HuYingTran/Robot_TRRR/digital_twin/meshes/Body018.stl

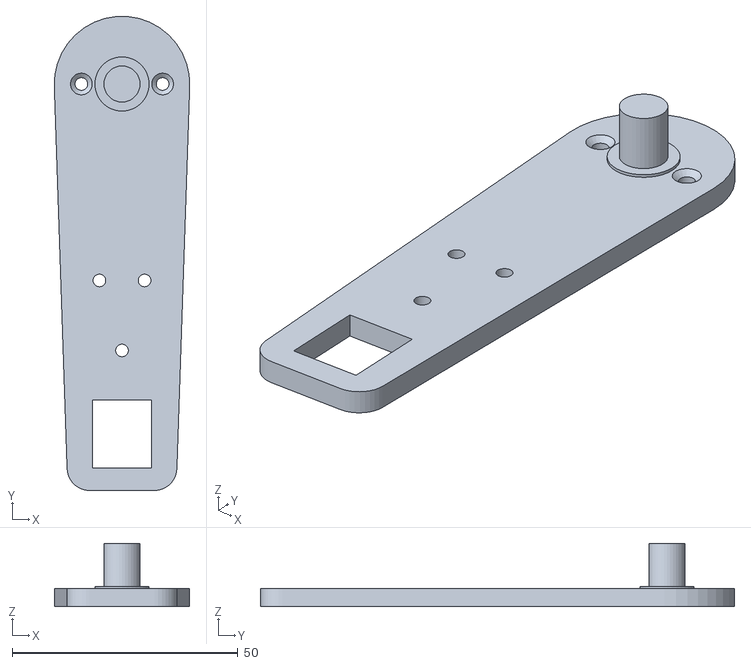
[picture p6: CAD file, 2026-10-16]
digital_twin/meshes/Body018.stl
30.0 x 104.9 x 14.0
