HuYingTran/Robot_TRRR/digital_twin/meshes/SoftGripper__Spool.stl

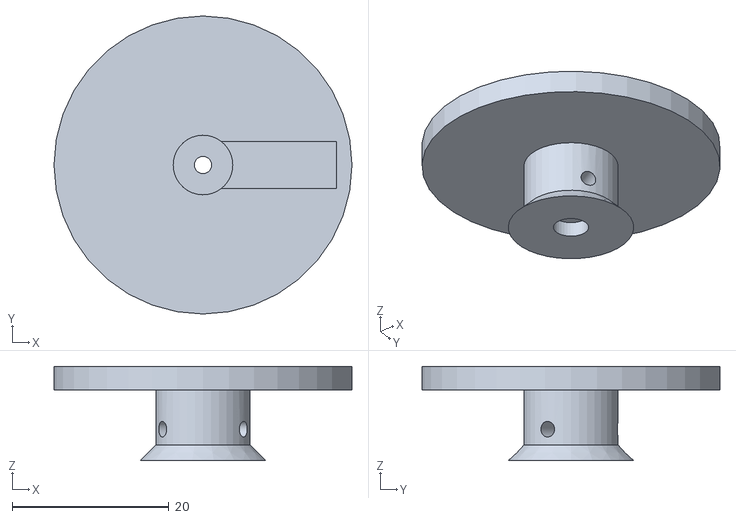
[picture p7: CAD file, 2026-10-16]
digital_twin/meshes/SoftGripper__Spool.stl
38.0 x 38.0 x 12.0
