HuYingTran/Robot_TRRR/digital_twin/meshes/SoftGripper__Palm.stl

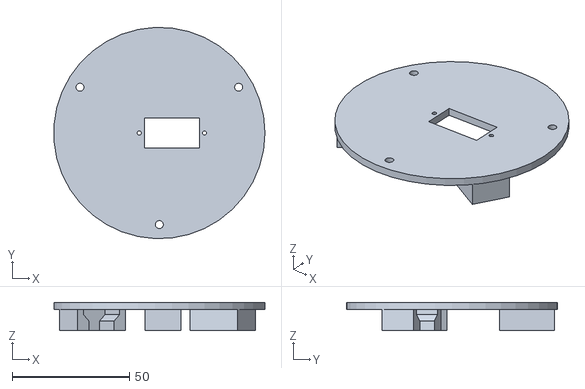
[picture p8: CAD file, 2026-10-16]
digital_twin/meshes/SoftGripper__Palm.stl
89.9 x 89.9 x 12.0
