HuYingTran/Robot_TRRR/digital_twin/meshes/Body016.stl

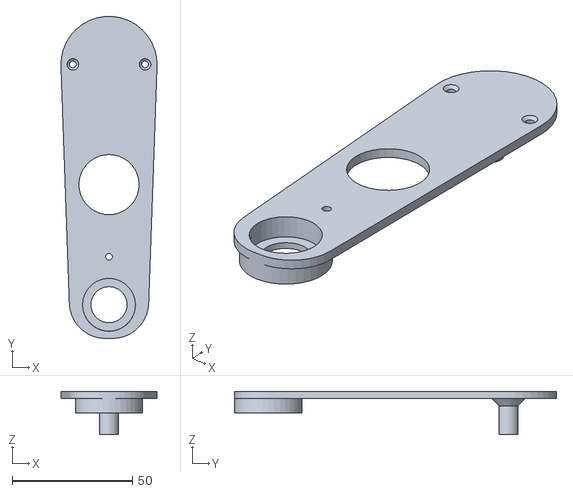
[picture p9: CAD file, 2026-10-16]
digital_twin/meshes/Body016.stl
40.0 x 133.9 x 18.0
