HuYingTran/Robot_TRRR/digital_twin/meshes/SoftGripper__SG90_ref.stl

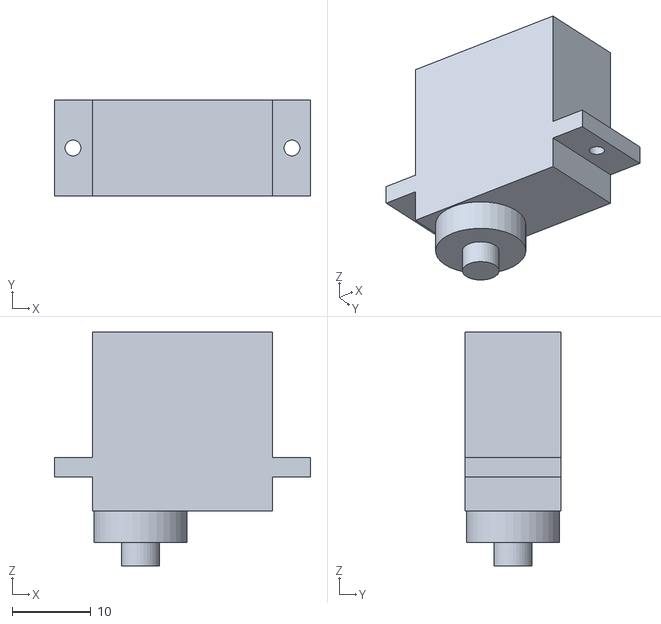
[picture p10: CAD file, 2026-10-16]
digital_twin/meshes/SoftGripper__SG90_ref.stl
32.5 x 12.2 x 29.7
