HuYingTran/Robot_TRRR/digital_twin/meshes/SoftGripper__Horn25_MG995_ref.stl

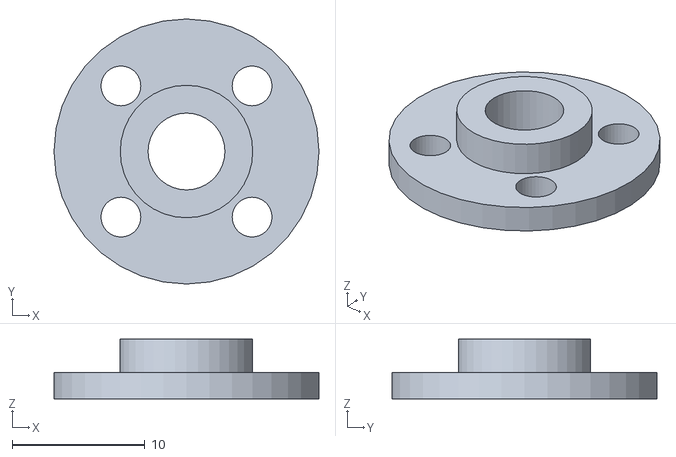
[picture p11: CAD file, 2026-10-16]
digital_twin/meshes/SoftGripper__Horn25_MG995_ref.stl
20.0 x 20.0 x 4.50
