HuYingTran/Robot_TRRR/digital_twin/meshes/Body010.stl

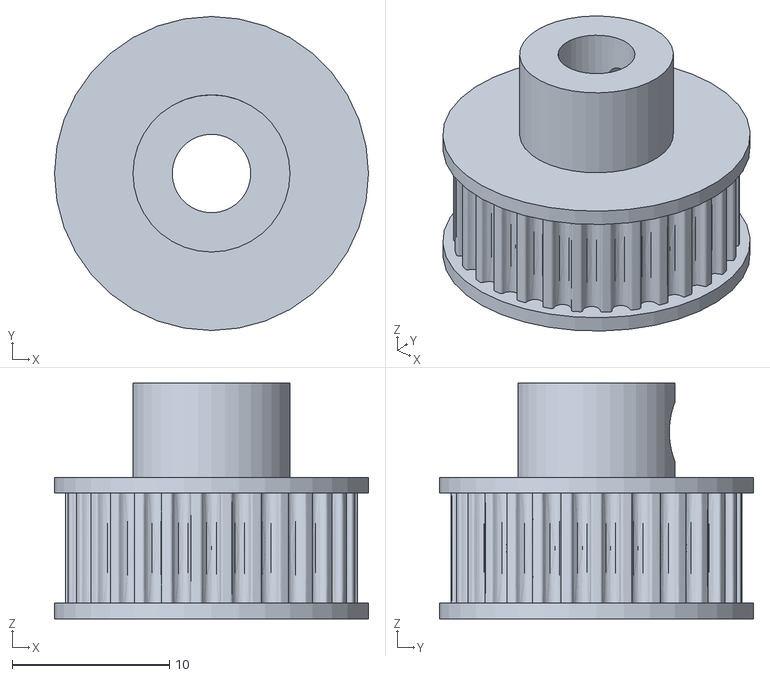
[picture p12: CAD file, 2026-10-16]
digital_twin/meshes/Body010.stl
20.0 x 20.0 x 15.0
