HuYingTran/Robot_TRRR/digital_twin/meshes/Body012.stl

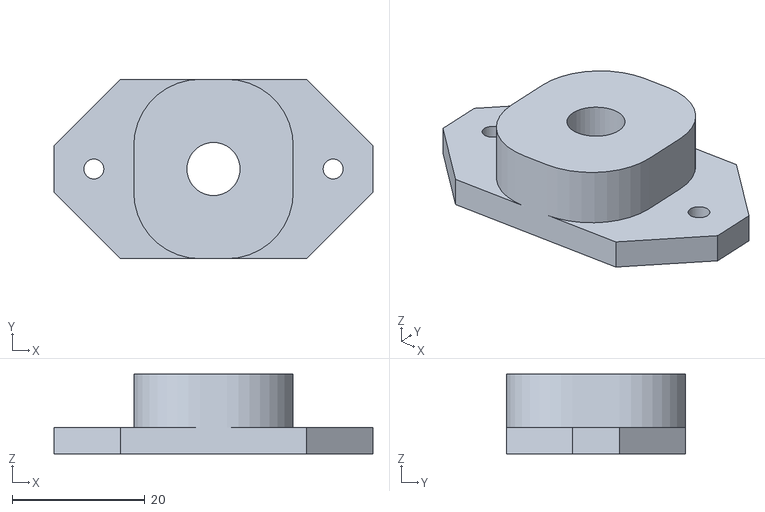
[picture p13: CAD file, 2026-10-16]
digital_twin/meshes/Body012.stl
48.0 x 27.0 x 12.0
