HuYingTran/Robot_TRRR/digital_twin/meshes/SoftGripper__Spacer.stl

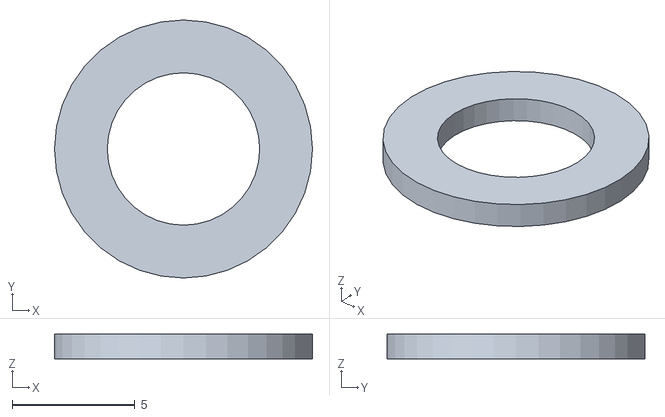
[picture p14: CAD file, 2026-10-16]
digital_twin/meshes/SoftGripper__Spacer.stl
10.5 x 10.5 x 1.00
