HuYingTran/Robot_TRRR/digital_twin/meshes/SoftGripper__Finger_2.stl

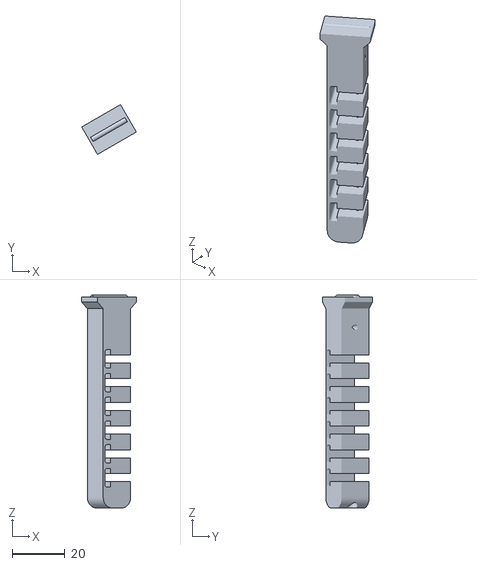
[picture p15: CAD file, 2026-10-16]
digital_twin/meshes/SoftGripper__Finger_2.stl
20.7 x 18.9 x 80.7
