HuYingTran/Robot_TRRR/digital_twin/meshes/Body.stl

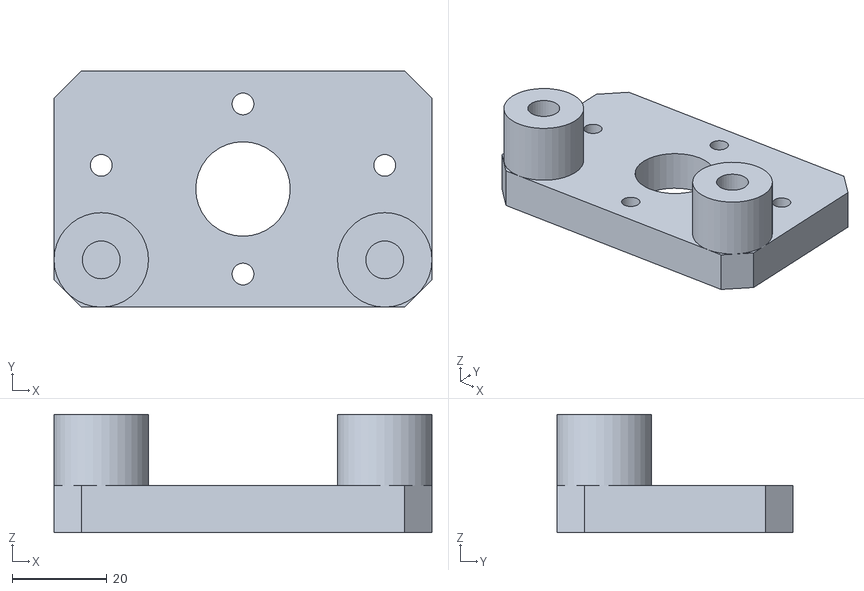
[picture p16: CAD file, 2026-10-16]
digital_twin/meshes/Body.stl
80.0 x 50.0 x 25.0
