HuYingTran/Robot_TRRR/digital_twin/meshes/Body004.stl

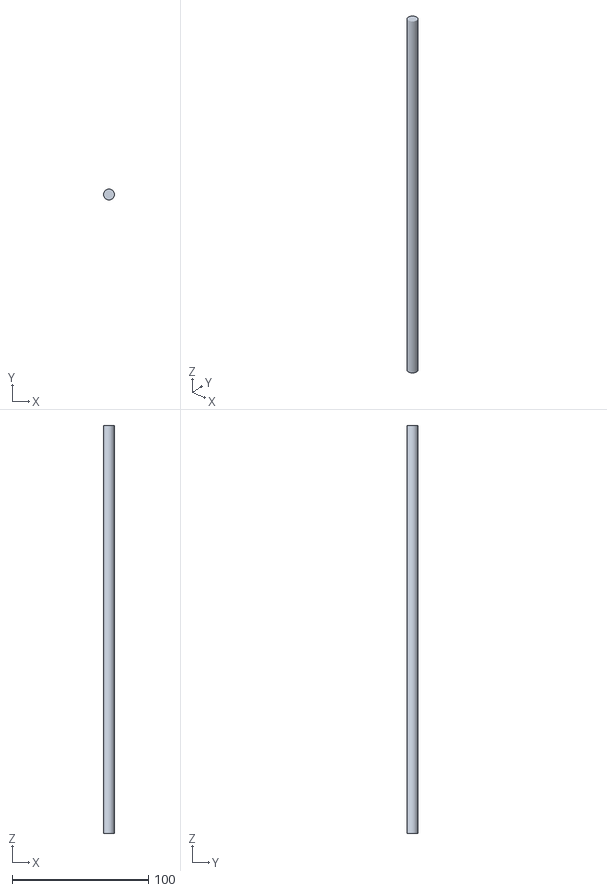
[picture p17: CAD file, 2026-10-16]
digital_twin/meshes/Body004.stl
8.00 x 8.00 x 300.0
