HuYingTran/Robot_TRRR/digital_twin/meshes/Body001.stl

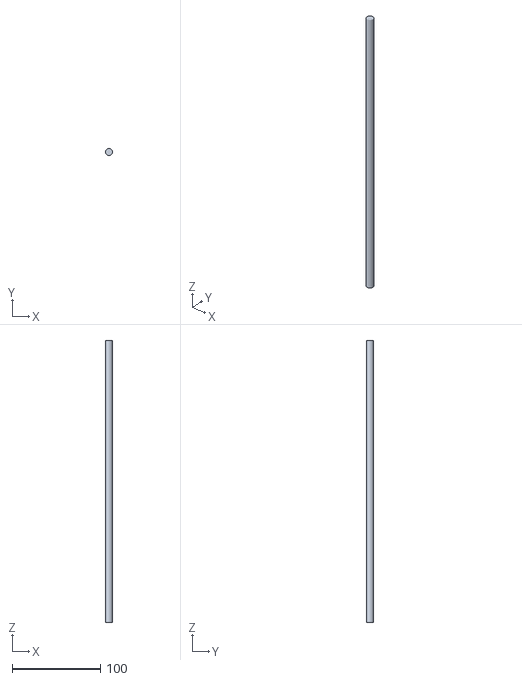
[picture p18: CAD file, 2026-10-16]
digital_twin/meshes/Body001.stl
8.00 x 8.00 x 320.0
