HuYingTran/Robot_TRRR/digital_twin/meshes/Body017.stl

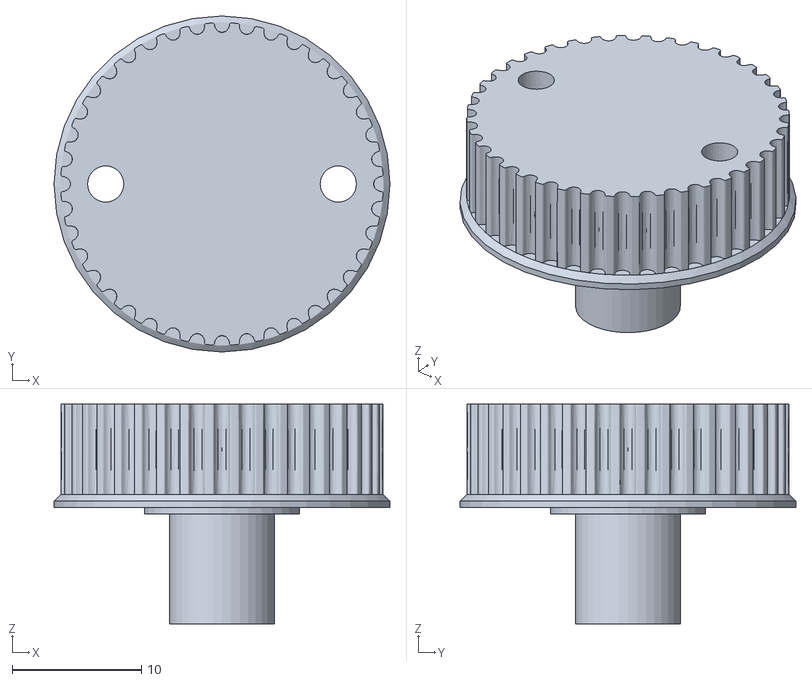
[picture p19: CAD file, 2026-10-16]
digital_twin/meshes/Body017.stl
26.0 x 26.0 x 17.0
