HuYingTran/Robot_TRRR/digital_twin/meshes/Body007.stl

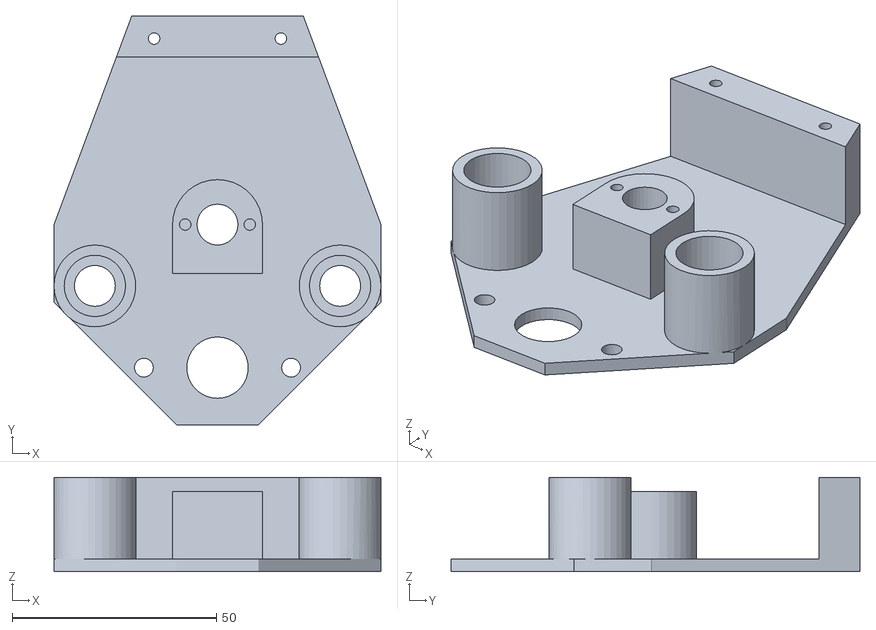
[picture p20: CAD file, 2026-10-16]
digital_twin/meshes/Body007.stl
80.0 x 100.0 x 23.0
