HuYingTran/Robot_TRRR/digital_twin/meshes/Body005.stl

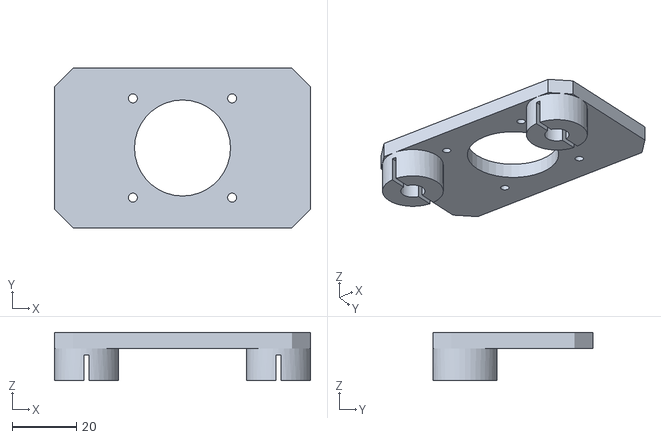
[picture p21: CAD file, 2026-10-16]
digital_twin/meshes/Body005.stl
80.0 x 50.0 x 15.0
