HuYingTran/Robot_TRRR/digital_twin/meshes/Body011.stl

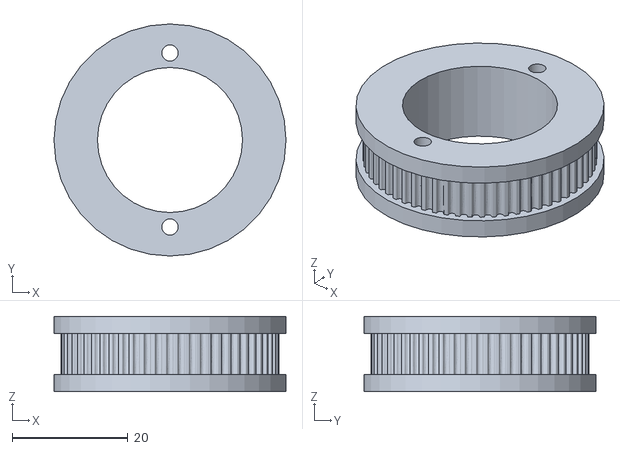
[picture p22: CAD file, 2026-10-16]
digital_twin/meshes/Body011.stl
40.0 x 40.0 x 13.0
