HuYingTran/Robot_TRRR/digital_twin/meshes/MG995.stl

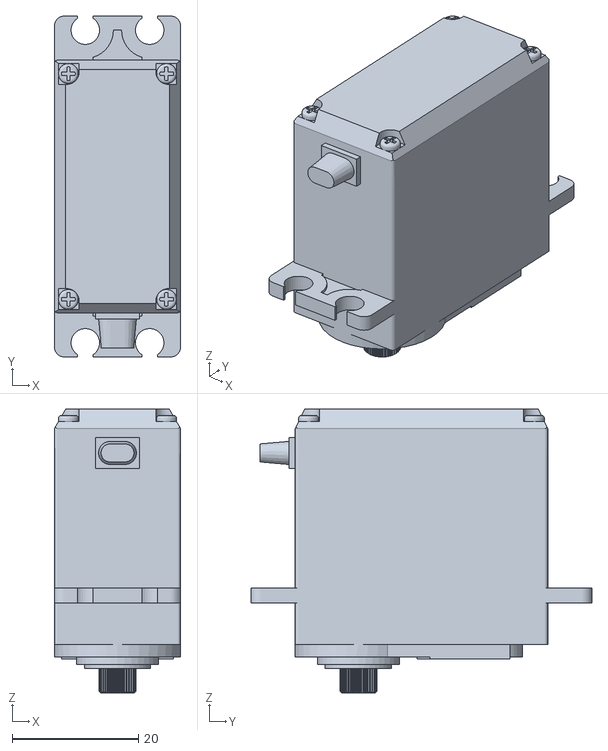
[picture p23: CAD file, 2026-10-16]
digital_twin/meshes/MG995.stl
20.0 x 54.0 x 45.0
