HuYingTran/Robot_TRRR/digital_twin/meshes/CREAILTY_4239.stl

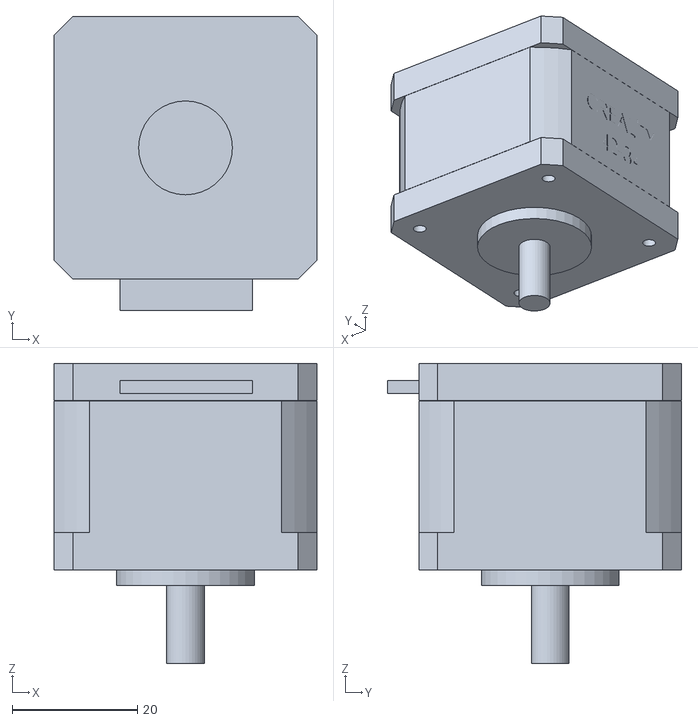
[picture p24: CAD file, 2026-10-16]
digital_twin/meshes/CREAILTY_4239.stl
42.0 x 47.0 x 48.0
