HuYingTran/Robot_TRRR/digital_twin/meshes/SoftGripper__Horn_ref.stl

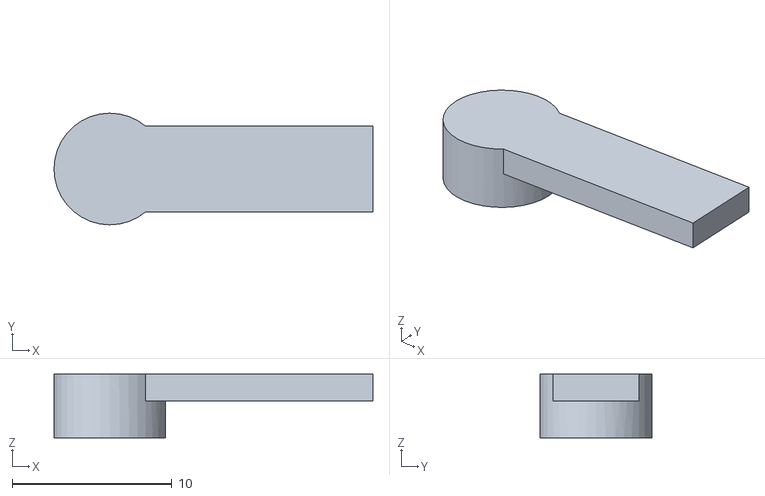
[picture p25: CAD file, 2026-10-16]
digital_twin/meshes/SoftGripper__Horn_ref.stl
20.0 x 7.00 x 4.00
