HuYingTran/Robot_TRRR/digital_twin/meshes/SoftGripper__Finger_1.stl

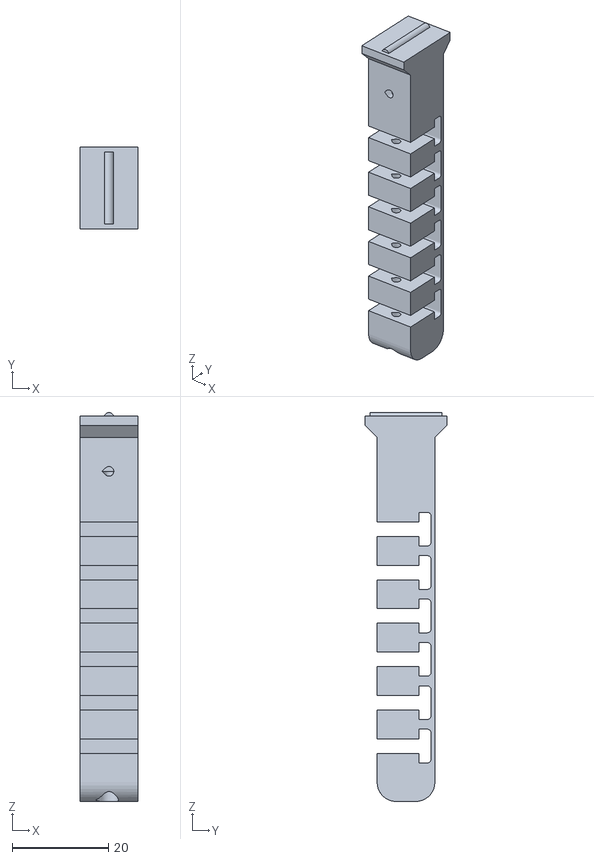
[picture p26: CAD file, 2026-10-16]
digital_twin/meshes/SoftGripper__Finger_1.stl
12.0 x 17.0 x 80.7
