HuYingTran/Robot_TRRR/digital_twin/meshes/Body009.stl

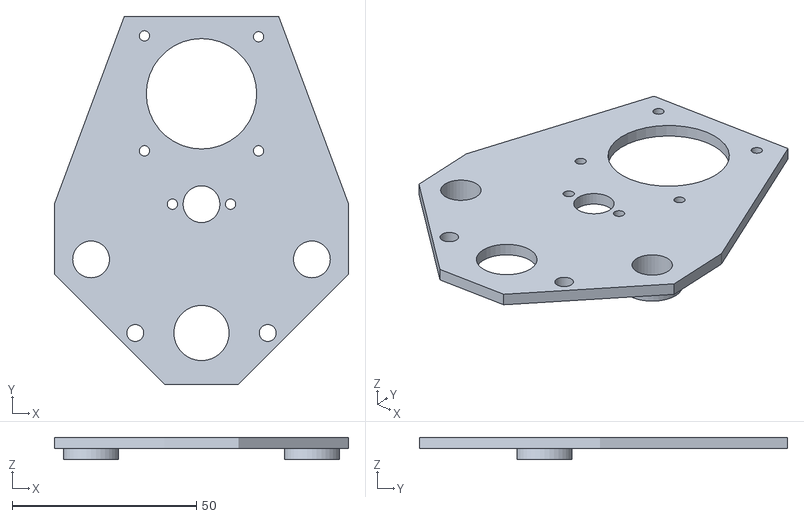
[picture p27: CAD file, 2026-10-16]
digital_twin/meshes/Body009.stl
80.0 x 100.0 x 6.00
