HuYingTran/Robot_TRRR/digital_twin/meshes/Body019.stl

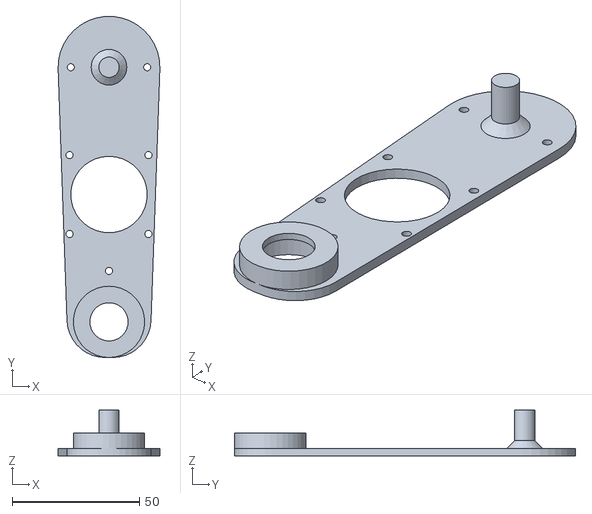
[picture p28: CAD file, 2026-10-16]
digital_twin/meshes/Body019.stl
40.0 x 133.9 x 18.0
