HuYingTran/Robot_TRRR/digital_twin/meshes/SoftGripper__Mount_MG995.stl

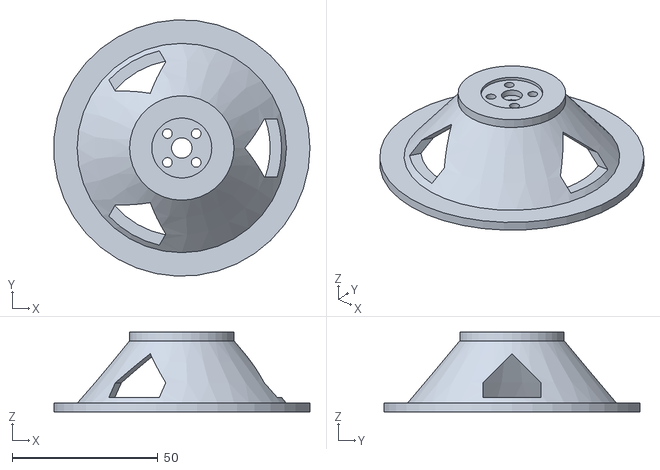
[picture p29: CAD file, 2026-10-16]
digital_twin/meshes/SoftGripper__Mount_MG995.stl
87.9 x 87.9 x 27.4
