HuYingTran/Robot_TRRR/digital_twin/meshes/Body021.stl

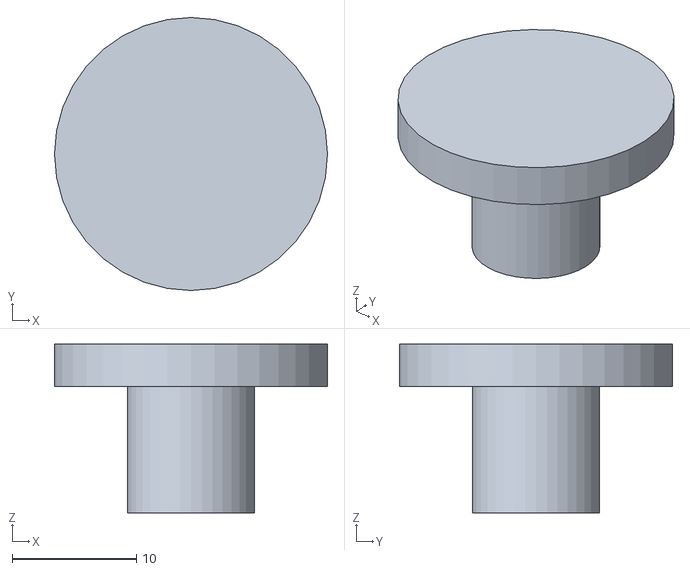
[picture p30: CAD file, 2026-10-16]
digital_twin/meshes/Body021.stl
22.0 x 22.0 x 13.6
