HuYingTran/Robot_TRRR/digital_twin/meshes/Body008.stl

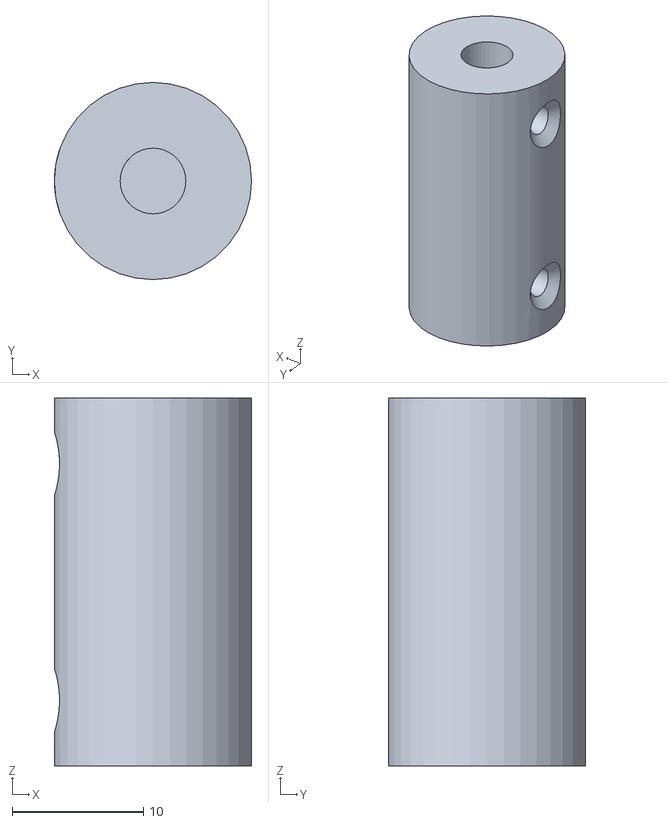
[picture p31: CAD file, 2026-10-16]
digital_twin/meshes/Body008.stl
15.0 x 15.0 x 28.0
