HuYingTran/Robot_TRRR/(list of files, cad)

Other CAD files:
digital_twin/meshes/SoftGripper__Finger_3.stl
digital_twin/meshes/Body015.stl
digital_twin/meshes/Body003.stl
digital_twin/meshes/CREAILTY_4238.stl
digital_twin/meshes/Body002.stl
digital_twin/meshes/Body013.stl
digital_twin/meshes/CREAILTY_4237.stl
