HuYingTran/Robot_TRRR/(commit log)

2026-10-16 Digital twin app (PyQt5/PyVista) and Arduino Nano firmware for Robot TRR
    - digital_twin: 3D simulation from FreeCAD meshes, FK/IK, PTP/LIN motion,
    teach program, collision checks, soft gripper finger-curl and grasp sim,
    serial/SIM link to the robot
    - firmware: PlatformIO project for Nano, 3 steppers (Timer2 step ISR) +
    MG995/SG90 servos, J/H/S/?/O/E serial protocol matching the app
    [Body.stl, Body001.stl, Body002.stl, Body003.stl, Body004.stl, Body005.stl, Body007.stl, Body008.stl]
2026-10-16 README: add app screenshots and soft gripper render
